AdamProbert/Cheddar/MotionDriver/src/outputs/MotorController.cpp

#include "MotorController.h"

namespace outputs
{

    namespace
    {
        // Wheel index -> DRV8833 channel, as the harness is physically wired.
        // The loom does not follow M1..M6 in wheel order: M1/M2/M3 carry the right
        // side front->rear, M4/M5/M6 the left side front->rear.
        //
        // Four of the six motors also have their leads reversed relative to the DRV8833
        // forward contract, so IN1/IN2 are swapped for those to keep FORWARD driving the
        // rover forward. Front Left and Middle Left are the exceptions and are wired the
        // normal way round -- don't "tidy" them into matching the others.
        //
        // Verified against hardware 2026-07-17 by driving every index in both directions
        // and watching which wheel turned and which way.
        constexpr int kMotorIn1Pins[MotorController::kMotorCount] = {
            PIN_M4_IN1, // 0 Front Left    (not reversed)
            PIN_M1_IN2, // 1 Front Right   (reversed)
            PIN_M5_IN1, // 2 Middle Left   (not reversed)
            PIN_M2_IN2, // 3 Middle Right  (reversed)
            PIN_M6_IN2, // 4 Rear Left     (reversed)
            PIN_M3_IN2  // 5 Rear Right    (reversed)
        };

        constexpr int kMotorIn2Pins[MotorController::kMotorCount] = {
            PIN_M4_IN2, // 0 Front Left
            PIN_M1_IN1, // 1 Front Right
            PIN_M5_IN2, // 2 Middle Left
            PIN_M2_IN1, // 3 Middle Right
            PIN_M6_IN1, // 4 Rear Left
            PIN_M3_IN1  // 5 Rear Right
        };
    }

    MotorController::MotorController(int standbyPin)
        : m_standbyPin(standbyPin),
          m_initialized(false),
          m_driverEnabled(false),
          m_lastUpdateMs(0)
    {
        for (uint8_t index = 0; index < kMotorCount; ++index)
        {
            auto &motor = m_motors[index];
            motor.in1Pin = kMotorIn1Pins[index];
            motor.in2Pin = kMotorIn2Pins[index];
            motor.channelA = index * kChannelsPerMotor;
            motor.channelB = motor.channelA + 1;
            motor.direction = Direction::Forward;
            motor.targetSpeed = 0.0f;
            motor.outputEnabled = false;
            motor.currentSignedSpeed = 0.0f;
        }
    }

    bool MotorController::begin()
    {
        pinMode(m_standbyPin, OUTPUT);
        digitalWrite(m_standbyPin, LOW);

        for (uint8_t index = 0; index < kMotorCount; ++index)
        {
            auto &motor = m_motors[index];

            pinMode(motor.in1Pin, OUTPUT);
            pinMode(motor.in2Pin, OUTPUT);
            digitalWrite(motor.in1Pin, LOW);
            digitalWrite(motor.in2Pin, LOW);

            ledcSetup(motor.channelA, kPwmFrequencyHz, kPwmResolutionBits);
            ledcSetup(motor.channelB, kPwmFrequencyHz, kPwmResolutionBits);

            ledcAttachPin(motor.in1Pin, motor.channelA);
            ledcAttachPin(motor.in2Pin, motor.channelB);

            ledcWrite(motor.channelA, 0);
            ledcWrite(motor.channelB, 0);
        }

        m_initialized = true;
        m_driverEnabled = false;
        m_lastUpdateMs = millis();

        return true;
    }

    void MotorController::update(uint32_t nowMs)
    {
        if (!m_initialized)
        {
            return;
        }

        const uint32_t elapsedMs = nowMs - m_lastUpdateMs;
        if (elapsedMs == 0)
        {
            return;
        }
        m_lastUpdateMs = nowMs;

        const uint32_t stepMs = (elapsedMs > kMaxRampStepMs) ? kMaxRampStepMs : elapsedMs;
        const float maxDelta = kSpeedRampPerSecond * (static_cast<float>(stepMs) / 1000.0f);

        bool anyChanged = false;

        for (uint8_t index = 0; index < kMotorCount; ++index)
        {
            auto &motor = m_motors[index];
            const float target = effectiveSignedTarget(index);
            const float diff = target - motor.currentSignedSpeed;

            if (diff == 0.0f)
            {
                continue;
            }

            if (fabsf(diff) <= maxDelta)
            {
                motor.currentSignedSpeed = target;
            }
            else
            {
                motor.currentSignedSpeed += (diff > 0.0f) ? maxDelta : -maxDelta;
            }

            applyOutput(index);
            anyChanged = true;
        }

        if (anyChanged)
        {
            updateStandby();
        }
    }

    void MotorController::run(uint8_t motorIndex, Direction direction, float speed, bool autoEnable)
    {
        if (!m_initialized || !validIndex(motorIndex))
        {
            return;
        }

        auto &motor = m_motors[motorIndex];
        motor.direction = direction;
        motor.targetSpeed = clampSpeed(speed);

        if (motor.targetSpeed == 0.0f)
        {
            motor.outputEnabled = false;
        }
        else if (autoEnable)
        {
            motor.outputEnabled = true;
        }

        applyOutput(motorIndex);
        updateStandby();
    }

    void MotorController::runAll(Direction direction, float speed, bool autoEnable)
    {
        if (!m_initialized)
        {
            return;
        }

        const float clamped = clampSpeed(speed);

        for (uint8_t index = 0; index < kMotorCount; ++index)
        {
            auto &motor = m_motors[index];
            motor.direction = direction;
            motor.targetSpeed = clamped;
            if (motor.targetSpeed == 0.0f)
            {
                motor.outputEnabled = false;
            }
            else if (autoEnable)
            {
                motor.outputEnabled = true;
            }
            applyOutput(index);
        }

        updateStandby();
    }

    void MotorController::start(uint8_t motorIndex)
    {
        if (!m_initialized || !validIndex(motorIndex))
        {
            return;
        }

        auto &motor = m_motors[motorIndex];
        motor.outputEnabled = motor.targetSpeed > 0.0f;
        applyOutput(motorIndex);
        updateStandby();
    }

    void MotorController::startAll()
    {
        if (!m_initialized)
        {
            return;
        }

        for (uint8_t index = 0; index < kMotorCount; ++index)
        {
            auto &motor = m_motors[index];
            motor.outputEnabled = motor.targetSpeed > 0.0f;
            applyOutput(index);
        }

        updateStandby();
    }

    void MotorController::stop(uint8_t motorIndex)
    {
        if (!m_initialized || !validIndex(motorIndex))
        {
            return;
        }

        auto &motor = m_motors[motorIndex];
        motor.outputEnabled = false;
        applyOutput(motorIndex);
        updateStandby();
    }

    void MotorController::stopAll()
    {
        if (!m_initialized)
        {
            return;
        }

        // Hard stop, deliberately un-ramped: this backs the deadman failsafe, E-STOP and
        // peer disconnect. Those must cut output now, not ease out of it. Per-motor
        // stop() is the one that ramps.
        for (uint8_t index = 0; index < kMotorCount; ++index)
        {
            m_motors[index].outputEnabled = false;
            m_motors[index].currentSignedSpeed = 0.0f;
            applyOutput(index);
        }

        updateStandby();
    }

    MotorController::Direction MotorController::direction(uint8_t motorIndex) const
    {
        if (!validIndex(motorIndex))
        {
            return Direction::Forward;
        }
        return m_motors[motorIndex].direction;
    }

    float MotorController::targetSpeed(uint8_t motorIndex) const
    {
        if (!validIndex(motorIndex))
        {
            return 0.0f;
        }
        return m_motors[motorIndex].targetSpeed;
    }

    bool MotorController::motorEnabled(uint8_t motorIndex) const
    {
        if (!validIndex(motorIndex))
        {
            return false;
        }
        return m_motors[motorIndex].outputEnabled;
    }

    bool MotorController::validIndex(uint8_t motorIndex) const
    {
        return motorIndex < kMotorCount;
    }

    float MotorController::clampSpeed(float speed) const
    {
        if (speed < 0.0f)
        {
            return 0.0f;
        }
        if (speed > 1.0f)
        {
            return 1.0f;
        }
        return speed;
    }

    void MotorController::applyOutput(uint8_t motorIndex)
    {
        if (!validIndex(motorIndex))
        {
            return;
        }

        // Driven by the ramped speed, not the commanded one -- update() walks
        // currentSignedSpeed toward the target and calls back in here.
        const auto &motor = m_motors[motorIndex];
        const uint32_t maxDuty = (1u << kPwmResolutionBits) - 1u;
        const float magnitude = fabsf(motor.currentSignedSpeed);

        if (magnitude <= 0.0f)
        {
            ledcWrite(motor.channelA, 0);
            ledcWrite(motor.channelB, 0);
            return;
        }

        // Speed is a fraction of the *usable* output, not of raw duty: 0 is stopped and
        // anything above it starts at kMinMovingDuty, the point where the wheels break
        // loose. Ramping raw duty from zero just buzzed for most of the ramp.
        const float scaledDuty = kMinMovingDuty + magnitude * (1.0f - kMinMovingDuty);
        const uint32_t duty = static_cast<uint32_t>(scaledDuty * static_cast<float>(maxDuty) + 0.5f);

        if (motor.currentSignedSpeed > 0.0f)
        {
            ledcWrite(motor.channelA, duty);
            ledcWrite(motor.channelB, 0);
        }
        else
        {
            ledcWrite(motor.channelA, 0);
            ledcWrite(motor.channelB, duty);
        }
    }

    float MotorController::effectiveSignedTarget(uint8_t motorIndex) const
    {
        const auto &motor = m_motors[motorIndex];
        if (!motor.outputEnabled)
        {
            return 0.0f;
        }
        return (motor.direction == Direction::Forward) ? motor.targetSpeed : -motor.targetSpeed;
    }

    void MotorController::updateStandby()
    {
        // A motor still coasting down to zero needs the drivers live to get there, so
        // a non-zero *current* speed counts as active just as much as a non-zero target.
        bool anyActive = false;
        for (uint8_t index = 0; index < kMotorCount; ++index)
        {
            if (m_motors[index].currentSignedSpeed != 0.0f || effectiveSignedTarget(index) != 0.0f)
            {
                anyActive = true;
                break;
            }
        }

        if (anyActive)
        {
            if (!m_driverEnabled)
            {
                digitalWrite(m_standbyPin, HIGH);
                m_driverEnabled = true;
            }
        }
        else
        {
            if (m_driverEnabled)
            {
                digitalWrite(m_standbyPin, LOW);
                m_driverEnabled = false;
            }
        }
    }

    void MotorController::disableOutputs()
    {
        for (uint8_t index = 0; index < kMotorCount; ++index)
        {
            auto &motor = m_motors[index];
            motor.currentSignedSpeed = 0.0f;
            ledcWrite(motor.channelA, 0);
            ledcWrite(motor.channelB, 0);
        }

        digitalWrite(m_standbyPin, LOW);
        m_driverEnabled = false;
    }
} // namespace outputs
