AdamProbert/Cheddar/PieBrain/ChedWeb/backend/models.py

"""Pydantic models for API requests and responses."""

from datetime import datetime
from typing import Literal

from pydantic import BaseModel, Field


class SDPOffer(BaseModel):
    """WebRTC SDP offer from client."""

    sdp: str = Field(..., description="Session Description Protocol offer")
    type: Literal["offer"] = Field(default="offer", description="SDP type")


class SDPAnswer(BaseModel):
    """WebRTC SDP answer from server."""

    sdp: str = Field(..., description="Session Description Protocol answer")
    type: Literal["answer"] = Field(default="answer", description="SDP type")


class HealthResponse(BaseModel):
    """Health check response."""

    status: str = Field(default="ok", description="Service status")
    timestamp: datetime = Field(default_factory=datetime.utcnow, description="Current timestamp")
    version: str = Field(default="0.1.0", description="API version")


class ControlCommand(BaseModel):
    """Robot control command sent via DataChannel.

    The rover has 6 independently driven and steered wheels:
    - Each wheel has a drive motor (speed control)
    - Each wheel has a steering servo (angle control)

    Wheel indexing (left to right, front to back):
    - 0: Front Left    - 1: Front Right
    - 2: Middle Left   - 3: Middle Right
    - 4: Rear Left     - 5: Rear Right

    Motors: Speed values range from -1.0 (full reverse) to 1.0 (full forward)
    Servos: Angle values range from 0-180 degrees (90 = straight ahead)
    """

    type: Literal["motor", "servo", "ping", "stop", "estop"] = Field(
        ..., description="Command type"
    )

    # 6-wheel drive motors
    motors: list[float] | None = Field(
        None,
        min_length=6,
        max_length=6,
        description="Array of 6 wheel motor speeds [-1.0 to 1.0], indexed 0-5",
    )

    # 6-wheel steering servos
    servos: list[int] | None = Field(
        None,
        min_length=6,
        max_length=6,
        description="Array of 6 wheel steering angles [0-180], indexed 0-5 (90=straight)",
    )

    # Legacy simple control (deprecated, kept for backwards compatibility)
    motor_left: float | None = Field(
        None, ge=-1.0, le=1.0, description="Deprecated: use motors array"
    )
    motor_right: float | None = Field(
        None, ge=-1.0, le=1.0, description="Deprecated: use motors array"
    )
    servo_pan: int | None = Field(None, ge=0, le=180, description="Deprecated: use servos array")
    servo_tilt: int | None = Field(None, ge=0, le=180, description="Deprecated: use servos array")

    timestamp: float = Field(..., description="Client timestamp in milliseconds")


class TelemetryData(BaseModel):
    """Telemetry data sent to client via DataChannel."""

    type: Literal["telemetry", "pong"] = Field(default="telemetry", description="Message type")
    battery_voltage: float | None = Field(None, description="Battery voltage in volts")
    current_draw: float | None = Field(None, description="Current draw in amps")
    cpu_temp: float | None = Field(None, description="CPU temperature in Celsius")
    signal_strength: int | None = Field(None, ge=0, le=100, description="WiFi signal strength %")
    timestamp: float = Field(..., description="Server timestamp in milliseconds")
    latency_ms: float | None = Field(None, description="Round-trip latency if pong")


class SystemMetrics(BaseModel):
    """System metrics data sent via DataChannel."""

    type: Literal["metrics"] = Field(default="metrics", description="Message type")
    cpu_percent: float = Field(..., description="CPU usage percentage")
    memory_percent: float = Field(..., description="Memory usage percentage")
    cpu_temp: float | None = Field(None, description="CPU temperature in Celsius")
    disk_percent: float | None = Field(None, description="Disk usage percentage")
    timestamp: float = Field(..., description="Server timestamp in milliseconds")


class ErrorResponse(BaseModel):
    """Standard error response."""

    error: str = Field(..., description="Error message")
    detail: str | None = Field(None, description="Additional error details")


class CameraSettings(BaseModel):
    """Camera settings update request."""

    awb_mode: str | None = Field(
        None, description="Auto white balance mode (auto, greyworld, daylight, tungsten, etc.)"
    )
    color_gains: tuple[float, float] | None = Field(
        None, description="Manual color gains (red, blue)"
    )
    framerate: int | None = Field(None, ge=1, le=60, description="Framerate in FPS")
    width: int | None = Field(None, ge=160, le=1920, description="Video width in pixels")
    height: int | None = Field(None, ge=120, le=1080, description="Video height in pixels")


class CameraSettingsResponse(BaseModel):
    """Camera settings update response."""

    success: bool = Field(..., description="Whether update was successful")
    needs_restart: bool = Field(
        default=False, description="Whether video track needs restart for changes to take effect"
    )
    current_settings: dict = Field(..., description="Current camera settings")
