AdamProbert/Cheddar/(commit log)

2025-09-17 Rename sketch_sep16a.ino to MotorDriver.ino
    Moved and renamed the Arduino sketch file from sketch_sep16a/sketch_sep16a.ino to MotorDriver/MotorDriver.ino for better organization and clarity.
2025-09-17 Add initial ServoMotorDriver implementation
    Introduces core files for ESP32-C3 motor and servo control: main logic, DRV8833 motor driver, PCA9685 servo control, and serial command parsing. Enables WASD and word-based serial commands for speed and steering, with smooth control loop and hardware initialization.
2025-09-18 Add multi-channel servo control and easing functions
    Expanded servo control to support 6 channels on the PCA9685, added functions to write to all servos with eased values, and updated initialization to center all servos. The changes improve flexibility for multi-servo setups and maintain compatibility with existing steering logic.
2025-10-06 feat: enhance UART command handling with sweep range and help commands
2025-10-06 feat: add MotorController class and integrate with UART command input
2025-10-06 feat: enhance MOTOR command to handle 6 motors
2025-10-06 feat: add comprehensive UART command help text and update documentation
2025-10-06 feat: add webapp with FastAPI for MotionDriver control, including servo and motor commands, logging, and sweep functionality
2025-10-18 feat: add setup script for Raspberry Pi to bootstrap Cheddar project environment
2025-11-08 feat: update CAMERA_SETUP.md and README.md for camera streaming setup and features
2025-11-08 feat: add validation exception handler for improved error logging and response
    [main.py]
2025-11-08 feat: enhance error logging in signaling offer handler and update virtualenv creation instructions
    [main.py]
2025-11-08 feat: Implement real-time system metrics monitoring via WebRTC DataChannel
    - Added SystemMetrics model to backend for CPU, memory, temperature, and disk usage data.
    - Integrated psutil for system monitoring in the backend.
    - Updated Zustand store to manage system metrics and maintain a rolling history of metrics data.
    - Created SystemMetricsCard component to display current metrics and time-series graphs using Recharts.
    - Enhanced WebRTC manager to handle incoming system metrics data.
    - Updated ConnectionControls to wire up system metrics updates.
    - Added new SystemMetricsSchema for type validation using Zod.
    - Updated package.json to include recharts for graphing capabilities.
    - Documented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
2025-11-08 feat: update camera configuration to support 180° flip and adjust documentation accordingly
    [camera.py, config.py, main.py, peer_manager.py]
2025-11-08 feat: update camera configuration to enable 180° flip
2025-11-08 fix: correct color channel order in captured frames from picamera2 to prevent purple tint
    [camera.py]
2025-11-08 feat: add support for NoIR camera adjustments and update color channel handling in PiCameraVideoTrack
2025-11-08 feat: add camera settings management with adjustable AWB mode and color gains
2025-11-08 feat: update camera initialization with default settings for NoIR cameras
2025-11-08 fix: correct AWB mode string casing in camera settings mapping
    [camera.py]
2025-11-08 feat: update AWB mode and color gains to manual settings for improved NoIR camera performance
2025-11-08 feat: implement camera settings management and update store with fetched settings
2025-11-08 feat: ensure we track entire input state
2025-11-09 refactor: remove outdated utility function tests for latency and battery voltage
2025-11-09 feat: integrate metrics for camera frame tracking and error logging
    [camera.py]
2025-11-09 feat: configure UART on GPIO 14/15 for serial communication with MotionDriver
2025-11-09 feat: update serial port configuration for Raspberry Pi GPIO UART
2025-11-09 feat: update UART configuration and permissions for Raspberry Pi GPIO
2025-11-09 feat: disable serial console on UART for ESP32 communication
2026-07-06 feat: remove MotorDriver.ino file and associated code
2026-07-06 feat: implement deadman failsafe for UART command input and enhance MotionDriver connection management
    [UARTCommandInput.cpp, UARTCommandInput.h, config.py, main.cpp, main.py, motion_driver_bridge.py, peer_manager.py]
2026-07-08 feat(chedweb): add Debug tab for per-actuator control and diagnostics
    Adds a Debug tab alongside Control with individual motor/servo control, a
    live ESP32 serial console, link-heartbeat monitoring, and Pi power/brownout
    flags. Backed by a new /ws/debug WebSocket independent of the WebRTC link so
    it works during brownouts.
    - backend/debug_hub.py: Broadcaster, PowerMonitor (vcgencmd get_throttled),
    loguru log capture, and raw-command whitelist (PING/HELP/MOTOR/S/SWEEP/LOG)
    - motion_driver_bridge.py: capture serial TX/RX (previously discarded) and
    track PING/PONG heartbeat RTT; mock bridge emits synthetic heartbeat
    - main.py: real /ws/debug (snapshot + stream + whitelisted commands), serve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
    [debug_hub.py, main.py, motion_driver_bridge.py]
2026-07-08 feat(chedweb): clearer Power & Brownouts panel with brownout/motor correlation
    - Headline health state (Power OK / Under-voltage / Throttling) derived from
    the live flags
    - Split live "Right now" vs sticky "Since boot" flags in plain language;
    bit refs demoted to tooltips
    - Event counters with timeframe: session total, last 60s, last event age
    - Timeline overlays under-voltage against motor commands on a shared axis so a
    motor-induced brownout is obvious
    - PowerMonitor now polls at 0.5s (was 2s) and exposes last_event_ts to catch
    fast inrush dips
    [debug_hub.py]
2026-07-08 feat: add heartbeat mechanism to maintain serial connection and prevent deadman failsafe
    [config.py, main.py, serial_bridge.py]
2026-07-16 fix: correct wheel mapping and servo units against real hardware
    The wheel index -> motor mapping never matched the loom. Commanding index 0
    (Front Left) drove the front right wheel, and every wheel ran inverted. The UI,
    the bridge and models.py all agreed on the documented 0=FL/1=FR contract, so the
    disagreement was the firmware's: M1-M3 carry the right side front->rear and
    M4-M6 the left side, and five of the six motors are lead-reversed. Middle Left
    is the exception and is wired the normal way round.
    Rover steering was separately broken. The bridge forwarded servo positions in
    degrees straight into the firmware's `S <ch> <us>`, which takes microseconds and
    clamps to 1000-2000. Every angl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
    [MotorController.cpp, motion_driver_bridge.py]
2026-07-16 fix(servos): map wheel index to the PCA9685 channel it is actually wired to
    The servo loom is mis-ordered like the motor loom was, but differently: the left
    side sits on channels 0-2 running rear->front, and the right side does not
    mirror it. Steering FL drove the rear left servo, FR drove middle left, and so
    on. There is no pattern to derive, so this is a lookup rather than a formula.
    Translated in writeMicroseconds, the one place a wheel index becomes a physical
    channel. Sweep state and pulse clamping stay wheel-indexed, so `S 0` means front
    left everywhere -- CLI, Debug tab and rover controls alike.
    Verified against hardware by driving each index and watching which wheel steered.
    Also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
    [ServoController.cpp]
2026-07-16 feat(motors): ramp motor speed instead of stepping to it
    Motors jumped straight to the commanded duty, which felt jerky and put a hard
    edge on the current draw. They now slew toward the target at ~3.0 units/s --
    roughly 330ms rest to full. Enough to take the edge off without feeling laggy.
    Done in firmware rather than the frontend so it covers every command source
    (rover controls, Debug tab, raw CLI) and cannot be made lumpy by network jitter.
    It should also help the brownouts: easing the ramp softens the inrush that sags
    the rail, which HARDWARE.md fingers as the cause.
    The ramped speed is signed, so a FORWARD<->BACKWARD change eases down through
    zero and back up rather than snapping acro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
    [MotorController.cpp, MotorController.h, main.cpp]
2026-07-16 fix(motors): map speed into the duty range where the wheels actually turn
    The wheels do not break loose below ~80% duty; below that the rover just buzzes.
    Ramping raw duty from zero therefore spent most of the ramp doing nothing and
    then lurched. A non-zero speed now maps into [0.80, 1.0] duty, so the ramp -- and
    the usable stick travel -- is all real movement.
    kMinMovingDuty is a fraction of whatever the motor rail is, so it is calibrated
    to the current 8.4V unbucked rail and must be re-measured if that changes.
    Records the measurement in HARDWARE.md, because it invalidates advice already
    written there. The overvolt section offered capping PWM duty at ~70% as a
    stopgap; that sits below th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
    [MotorController.cpp, MotorController.h]
2026-07-17 feat(chedweb): add speed limit control, defaulting to 75% power
    Full stick/key deflection previously commanded 100% motor power, which is
    more than the rover needs indoors. Scale the commanded speed by an
    adjustable limit that defaults to 75%.
    The scale lives in InputManager and is applied after the drive-mode
    kinematics, so it covers keyboard and gamepad alike and keeps modes like
    tank (which mixes forward and turn per side) balanced while lowering
    their magnitude.
    The slider stops arrow-key propagation while focused, since the arrows
    are also bound on window as steering input; E-stop keys still pass
    through.
2026-07-17 fix(motors): correct motor lead reversal documentation and update verification date
    [MotorController.cpp]
2026-07-17 feat(steering): all-wheel Ackermann with wider lock; camera defaults
    Ackermann and point-turn now steer all four corner wheels about a common
    turn centre: the front pair steers into the corner and the rear pair
    counter-steers by an equal amount, roughly halving the turning radius.
    Steer angles are solved from each wheel's geometry so the inner wheel of
    each axle turns sharper than the outer (true Ackermann), and the max lock
    is raised from 45 to 75 degrees at the inner front wheel. Middle wheels
    stay straight, which the geometry produces on its own.
    Also bumps camera defaults: framerate 30->60 and AWB manual->auto.
    [config.py, main.py]
2026-07-17 fix(steering): soften Ackermann outer-wheel differential
    The geometrically-true inner/outer split was too aggressive at a 75-degree
    lock, leaving the outer wheel barely turning (~24 degrees). Add an
    ACKERMANN_DIFFERENTIAL knob (default 0.5) that scales how much the outer
    wheel eases off; the inner wheel still reaches full lock so the turning
    circle is unchanged. Outer front now reaches ~38 degrees at full lock.
